tessel/reach-nrf51822-hardware/README.md

# reach-hardware

EE design files for a tiny, Bluetooth Low Energy Tessel!
