tessel/reach-nrf51822-hardware/vreg-enable-sim.asc

C1: cap; 100e-9
I1: current; 220E-9
R1: res; {RTOP}
R2: res; 100e3
R3: res; {RADC}
S1: sw; ""
V1: voltage; 3
V2: voltage; PULSE(0 1 2E-5 1E-15 1E-15 50E-6)
Named nets: 0, vin, sample_pulse, ADC, EN
.tran 1E-4
.param radc=250e3 RTOP=210e3
.step param radc list 240e3 250e3 260e3
.step oct param rtop 400e3 700e3 10
.model MySwitch SW(Ron=1e-9 Roff=1e105 Vt=0 Vh=-.5 Lser=1e-12)
0.4V - RTOP=619e3
