tessel/reach-nrf51822-hardware/(commit log)

2015-02-03 kicad project setup
    [reach-target-hw.sch]
2015-02-03 "qfaa qfn48 w/ dcdc" reference design in
    [reach-target-hw.sch]
2015-02-03 more precise values, packages
    [reach-target-hw.sch]
2015-02-03 underscores over hyphens
    [reach-target-hw.sch]
2015-02-04 added power plant (ncp103). still needs some tweaks re. enable line...
    [reach-target-hw.sch]
2015-02-05 added eeprom. can be no-popped
    [reach-target-hw.sch]
2015-02-06 connected eeprom wp
    [reach-target-hw.sch]
2015-02-06 added swd/cortex debug pinout. related: none of the nordic reference designs are useful...stupid debugger/usb-to-serial micros are in the way.
    [reach-target-hw.sch]
2015-02-06 module ports and pps
    [reach-target-hw.sch]
2015-02-06 nelist and comment about spice sim
    [reach-target-hw.sch]
2015-02-06 lt spice sim for regulator enable
2015-02-09 pins were reversed
    [reach-target-hw.sch]
2015-02-09 ignore the last message... tweaked battery monitor, found real crystals
    [reach-target-hw.sch]
2015-02-09 "last" schematic changes
    [reach-target-hw.sch]
2015-02-09 hello, pcb
    [reach-target-hw.kicad_pcb]
2015-02-09 done goofed and did inconsistent refdes numbering. reset.
    [reach-target-hw.kicad_pcb, reach-target-hw.sch]
2015-02-09 grid offset things established. placeholder board outline.
    [reach-target-hw.kicad_pcb]
2015-02-09 dcdc inductors
    [reach-target-hw.kicad_pcb, reach-target-hw.sch]
2015-02-09 preliminary bom for jia
    [reach-target-hw.csv]
2015-02-09 symbol swap for 4pin xtal
    [reach-target-hw.sch]
2015-02-09 forgot to connect the eeprom
    [reach-target-hw.kicad_pcb, reach-target-hw.sch]
2015-02-09 preliminary placement, i2c pull resistors
    [reach-target-hw.kicad_pcb, reach-target-hw.sch]
2015-02-09 never thought fitting all the io breakout would be the hard part of this board...
    [reach-target-hw.kicad_pcb, reach-target-hw.sch]
2015-02-10 well there goes most of the layout...and the avdd return path :/
    [reach-target-hw.kicad_pcb, reach-target-hw.sch]
2015-02-10 first pass layout done
    [reach-target-hw.kicad_pcb]
2015-02-10 tweak, tweak, segfault, tweak, segfault, tweak, segfault, segfault, ragequit, dinner
    [reach-target-hw.kicad_pcb]
2015-02-10 swapped in real button
    [reach-target-hw.kicad_pcb, reach-target-hw.sch]
2015-02-10 swapped some footprint 3d models. muuuuch better.
    [reach-target-hw.kicad_pcb]
2015-02-10 better models
    [reach-target-hw.kicad_pcb, reach-target-hw.sch]
2015-02-10 models and a new bom
    [reach-target-hw.csv, reach-target-hw.kicad_pcb]
2015-02-11 trying to rename nets elegantly... wish me luck
    [reach-target-hw.kicad_pcb, reach-target-hw.sch]
2015-02-11 renemed nets, labeled pins
    [reach-target-hw.kicad_pcb, reach-target-hw.sch]
2015-02-11 silk normalization
    [reach-target-hw.kicad_pcb]
2015-02-11 pass (relavant) drc, added mfg notes
    [reach-target-hw.kicad_pcb]
2015-02-11 "final" bom and updated silk
    [reach-target-hw.csv, reach-target-hw.kicad_pcb]
2015-02-11 silk to port names
    [reach-target-hw.kicad_pcb]
2015-02-11 kicad bug almost cost us the whole board. got it back.
    [reach-target-hw.kicad_pcb]
2015-02-11 until this bug (https://bugs.launchpad.net/kicad/+bug/1421008) gets fixed, here is my solution to the "your text is too long so imma corrupt your board, kthxbai" problem
    [reach-target-hw.kicad_pcb]
2015-02-12 retooled for 7mil drc. passes.
    [reach-target-hw.kicad_pcb, reach-target-hw.sch]
2015-02-16 mask on puzzles
    [reach-target-hw-B_Cu.gbr, reach-target-hw-B_Mask.gbr, reach-target-hw-Cmts_User.gbr, reach-target-hw-Edge_Cuts.gbr, reach-target-hw-F_Cu.gbr, reach-target-hw-F_Mask.gbr, reach-target-hw-F_Paste.gbr, reach-target-hw-F_SilkS.gbr]
