tessel/reach-nrf51822-hardware/(notices)

Notices in the files:
reach-target-hw.kicad_pcb:
Copyright 2015
COPYRIGHT 2015 TECHNICAL MACHINE, INC. ALL RIGHTS RESERVED.
